buming68/temp-humi-1ch-1020/DOCUMENT/程序烧录界面说明.JPG

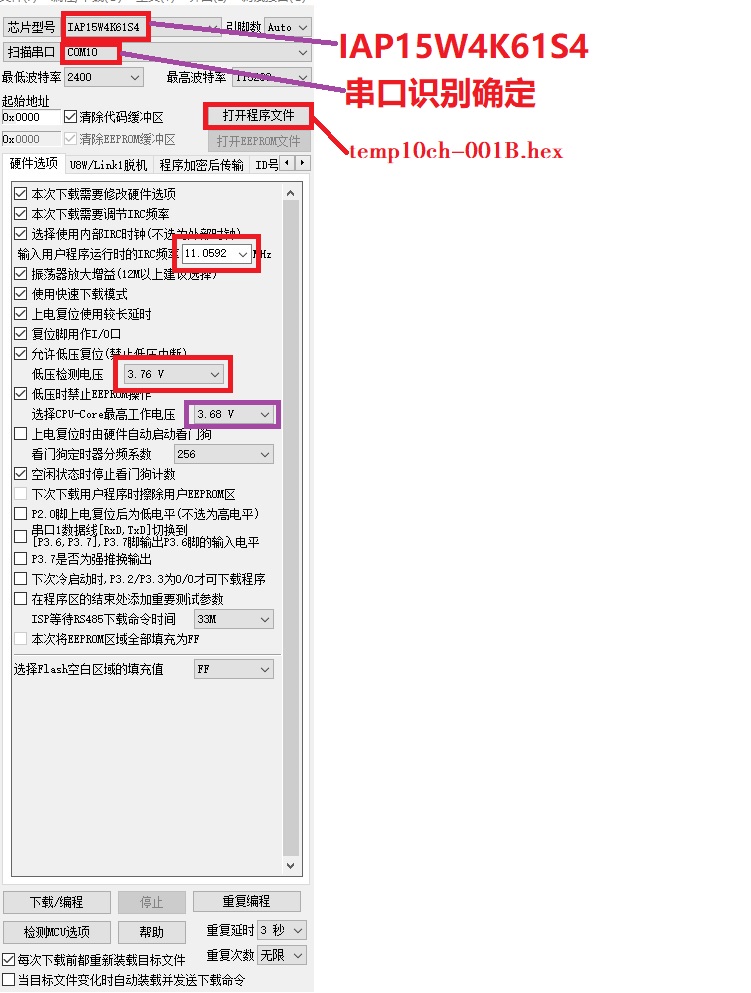
DOCUMENT/程序烧录界面说明.JPG
