buming68/temp-humi-1ch-1020/(list of files, cad)

Other CAD files:
OUTPUT/main.obj
OUTPUT/timer.obj
OUTPUT/sht30.obj
OUTPUT/config.obj
OUTPUT/wdt.obj
OUTPUT/uart.obj
OUTPUT/flashrom.obj
OUTPUT/receservice.obj
OUTPUT/i2c.obj
