buming68/temp-humi-1ch-1020/(commit log)

2023-05-11 单路温度湿度物联网监测软件 Ver 1.0C
    [config.obj, flashrom.obj, i2c.obj, main.obj, receservice.obj, sht30.obj, timer.obj, uart.obj]
2023-05-15 说明书文档更新
    [播出机房温度监测时间间隔图（20220930）.xlsx]
